ThDeDeyn/ELEC_424_Project/README.md

# ELEC_424_Project
This repository includes all the codes used for the project "Smart Care Wound : Device Design", part of the course ELEC-424 (Active Medical Device)

All the codes used in the project are uploaded to this repository. 
Additional documents used are also provided in this repository. 

The members of the group are : 

- Thomas De Deyn (ULB)
- Kiên Tran Ngoc (ULB)
- Mohamed Elamri (ECAM)
- Hugo De Marez (ULB)
