ThDeDeyn/ELEC_424_Project/_Report/ELEC-H424_SmartWoundCare_DeviceDesign.pdf

# Smart Wound Care: Device design

### Active Medical Device (ELEC-H424)

## 1. Introduction

## 2. Biomarkers

## 3. Sensors

## 4. PCB

## 5. Prototype

### - Chronic wounds :

- Result from variety of medical conditions (obesity, hypertension, …)

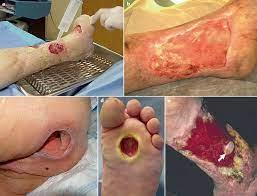
[picture p1: figure]

### - Crucial to monitor the progression of a wound - Nowadays = visual inspection of the skin - Goal = use smart bandages

## 1. Introduction

## 2. Biomarkers

## 3. Sensors

## 4. PCB

## 5. Prototype

pH

### - Infection indicator marker

### - Normal skin : pH alkaline (≈7)

### - Wound : pH between 5.5 and 6.5

### - pH>6 ➔ appearance of human-pathogenic bacteria

### - Incidence on the effectiveness of antibiotics and antiseptics

# - Biochemical markers

Disadvantage(s)

- Very expensive sensor
- Length of the sensor (10 cm minimum)

Advantage(s)

- Precise information

# - Physical markers

### Temperature

### - Infection indicator marker

### - Increasing temperature around a wound associated to the presence of an infection

Disadvantage(s)

- Depends on the environment’s temperature
- Could vary a lot during the day (exercise,…)

Advantage(s)

- Very easy to measure
- Associated to a defence
mechanism
- Cheap sensor

### Oxygen

### - Slow recovery monitoring marker

### - Concentration around a wound = important factor for healing

### - Helps eliminate bacteria and debris in the wound

Disadvantage(s)

- sp02 sensor
- More expensive than other sensors

Advantage(s)

- Constant value
- Small sensor

### Humidity

### - Slow recovery monitoring marker

### - Wound moisture balance = critical for optimum healing conditions

Disadvantage(s)

- Sensor must be placed closed to the wound

Advantage(s)

- Easy to measure
- Small & cheap sensor

### Pressure

### - Slow recovery monitoring marker

### - Exerted pressure ranges from 14 to 40 mmHg in the bandages

Disadvantage(s)

- Sensor must be placed closed to the wound

Advantage(s)

- Easy to measure
- Improves the healing speed
- Cheap sensor

## 1. Introduction

## 2. Biomarkers

## 3. Sensors

## 4. PCB

## 5. Prototype

# Sensors

### Control board – Arduino Nano 33 BLE

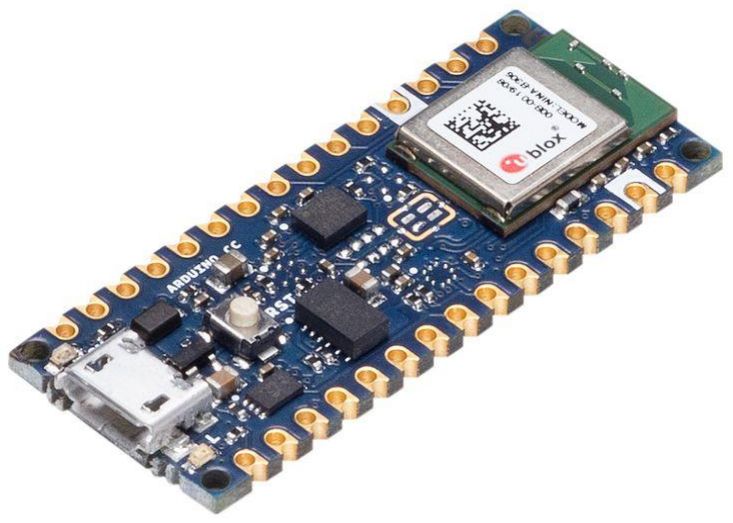
[picture p2: figure]

- Voltage output : 5V and 3.3V
- Communication protocol: I2C capable,

Bluetooth serial communication

- Coding language : C++ based
- Accessibility : fast delivery, relatively

cheap

- Improved performanceq: enables to treat

all the data needed

# Sensors

### Humidity and temperature sensor – SHT40-AD1B-R2

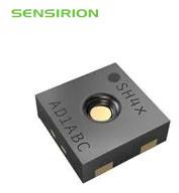
[picture p3: figure]

- Accuracy on the humidity : ± 1%
- Accuracy on the temperature : ± 0.1°C (@25°C)
- Power supply : 1.08V to 3.6V, Ultra-low-power
- Accessibility : available by 1
- Ease of use : Library available and I2C capable

# Sensors

### Oxygen level sensor – MAXREFDES117

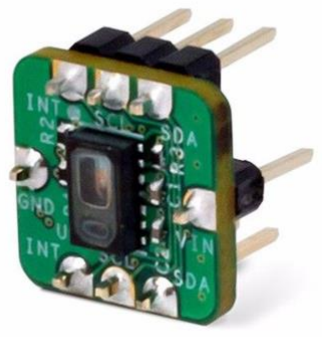
[picture p4: figure]

- Accuracy : ± 2% (for saturation levels ranging from

70% to 100%

- Power supply : 2V to 5.5V
- Accessibility : available by 1
- Ease of use : Open source library available and I2C

capable

# Sensors

### Pressure sensor – Round Force Sensor FSR402

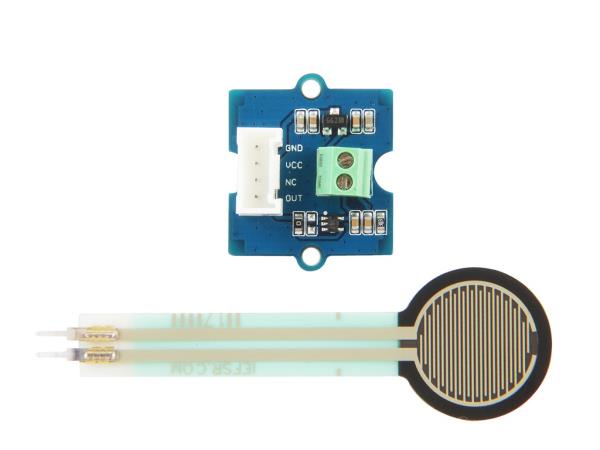
[picture p5: figure]

- Accuracy : Continuous (analog)
- Power supply : 3.3V or 5V
- Accessibility : available by 1
- Ease of use : Value directly read using the µC

(Analog input pin)

## 1. Introduction

## 2. Biomarkers

## 3. Sensors

## 4. PCB

## 5. Prototype

# PCB

## Why was it important ?

### - Good connection between the components

### - Simplify wiring and reduced short-circuit risks

### - Space optimisation

### - Improved comfort and discretion for patients

# PCB

### Issues :

### - Pin → 0,3mm ∅

### - Road as wide as possible (1mm)

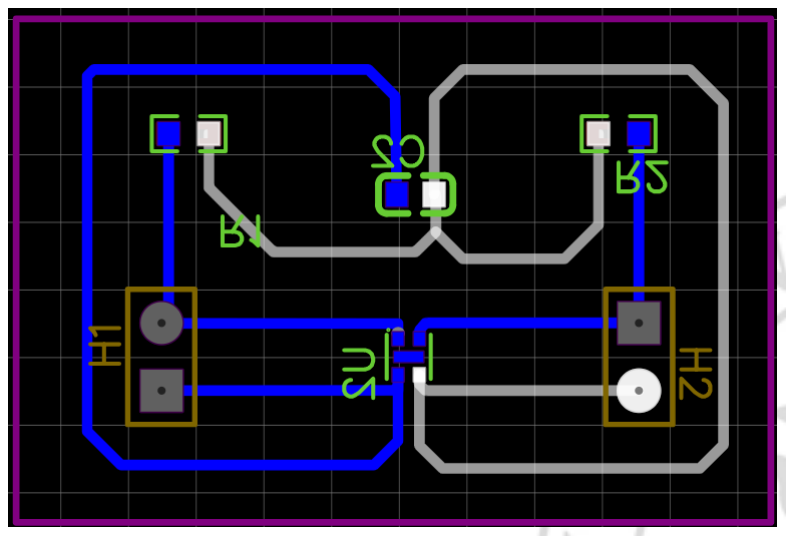
[picture p6: figure]

### - Create a PCB for the humidity sensor

# PCB

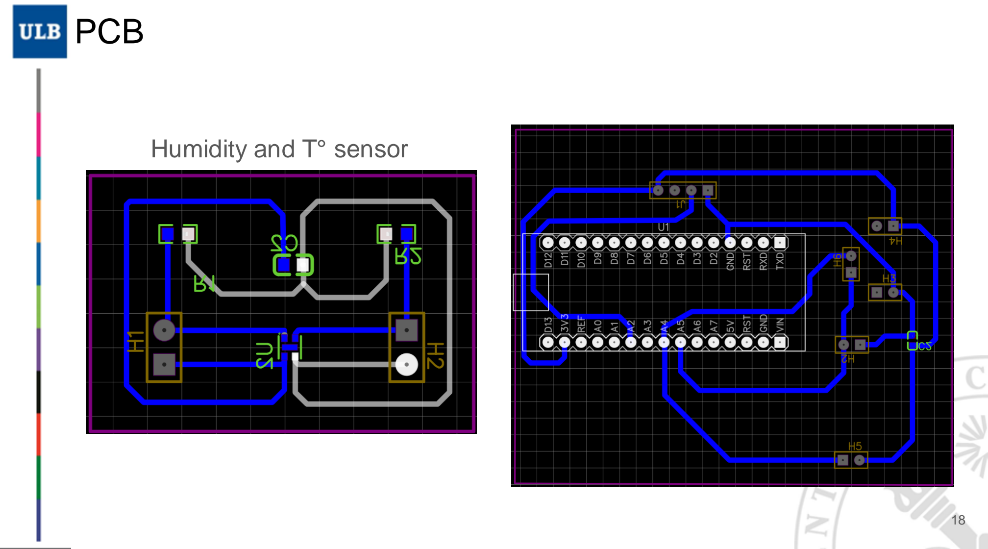
[picture p7: page 18]

### Humidity and T° sensor

## 1. Introduction

## 2. Biomarkers

## 3. Sensors

## 4. PCB

## 5. Prototype

# Prototype

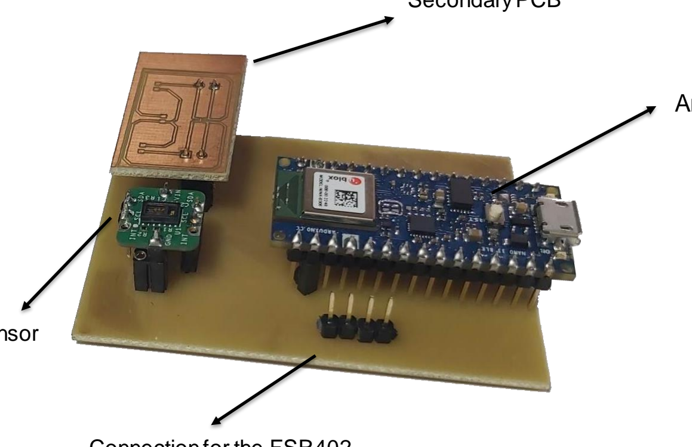
[picture p8: figure]

Arduino Nano

spO2 sensor

Secondary PCB

Connection for the FSR402

# Prototype : current state

### - Validation step proposed:

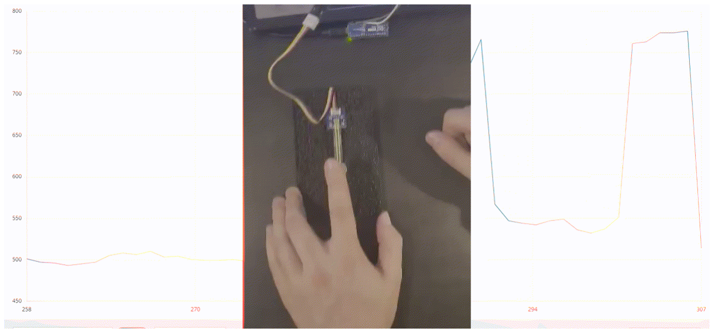
[picture p9: figure]

- Using balance weights placed on the sensor

## - Measuring the pressure

# Prototype : current state

## - Measuring the temperature

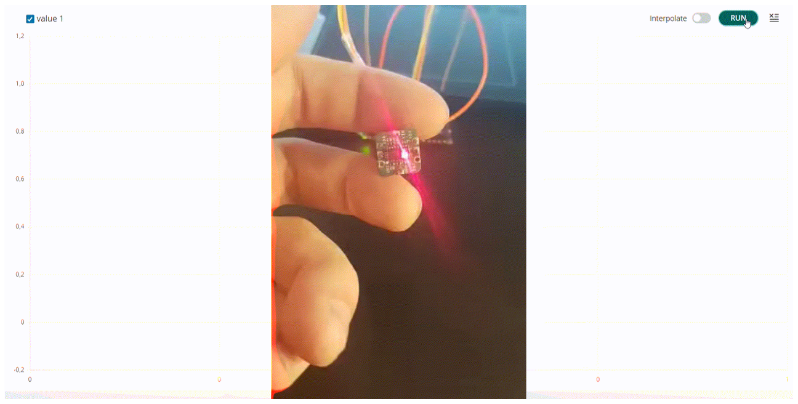
[picture p10: figure]

### - Validation steps performed :

- Placing a finger on the sensor raises the temperature
- Placing a cooled finger on the sensor decreases the temperature

# Prototype : current state

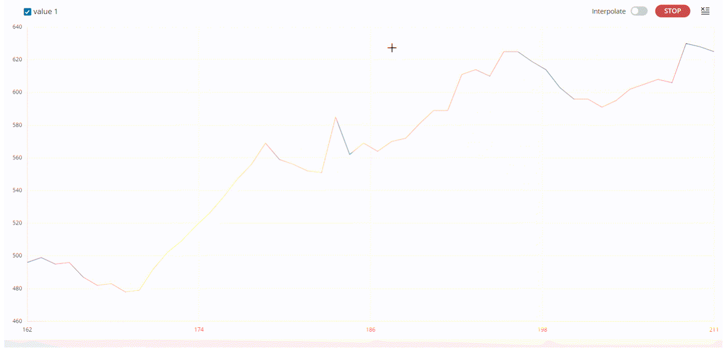
[picture p11: figure]

### - Validation steps performed :

- Compared with an hospital-grade oxymeter
- BPM value measured by hand

## - Measuring the BPM and spO2

# Prototype : current state

## - Measuring the BPM and spO2

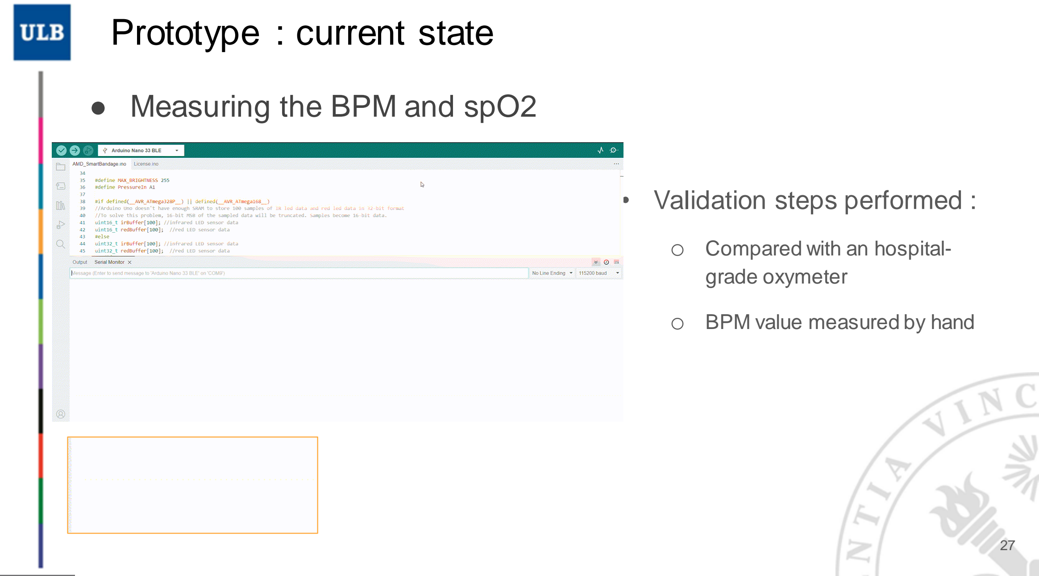
[picture p12: page 24]

### - Validation steps performed :

- Compared with an hospital-grade oxymeter
- BPM value measured by hand

# Prototype : next steps

## What remains to be done to test it in real conditions?

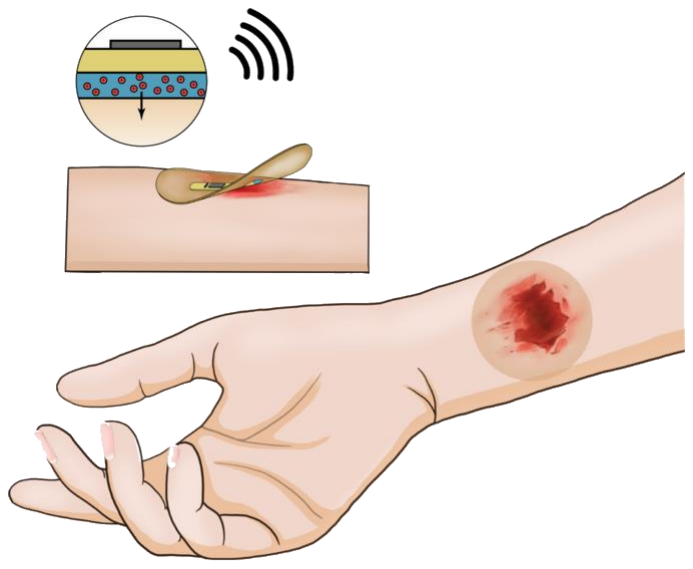
[picture p13: figure]

Jian-Cheng Lai, Bao Research Group (Stanford University)

# Prototype : next steps

### - Using the SHT40

### - Test both PCBs

### - Choosing a more adequate shape for the pressure sensor

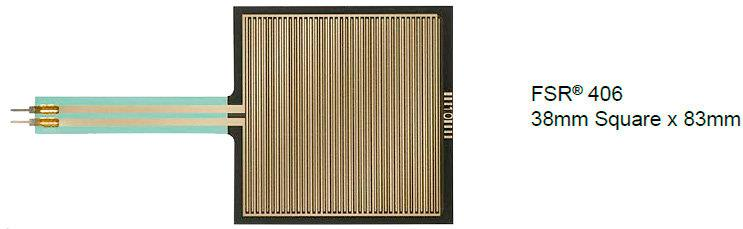
[picture p14: figure]

# Prototype : next steps

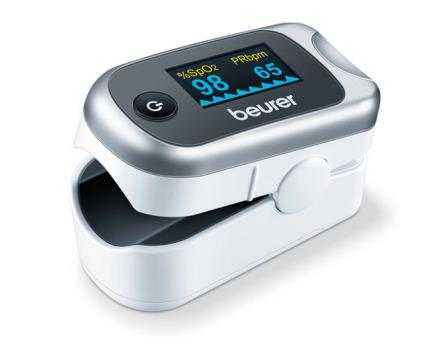
[picture p15: figure]

### - Stabilise the sensors

### - Develop a wearable circuit

- Using a flexible PCB
- Reducing the size of the components
- Apply safety standards
- Allow wireless communication

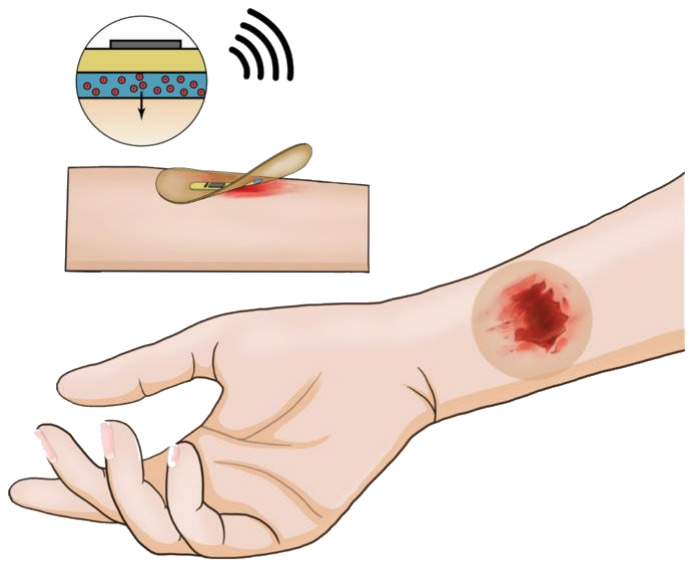
[picture p16: figure]

Jian-Cheng Lai, Bao Research Group (Stanford University)

# Thank you for your attention!

# Any questions?

### Active Medical Device (ELEC-H424)

# Other non-selected Markers

### - Nitric oxide

- Promotes cell growth, cell migration, new blood vessel formation and stimulation of collagen production
- Concentration between50 and 500 nM
- No sensor for aqueous environment

### - Uric acid

- Waste product
- Indicator of oxidative stress and bacterial infection
- Chronic wounds = hypoxic ➔ increase of purine metabolites concentration
- Too large

### - Proteases

- responsible for the balance between extracellular matrix (ECM) degradation and deposition
- Disrupt in the balance ➔ state of chronic inflammation
- Too complex (colorimetric or fluorescent study ➔ need of light and camera)

# Markers

### - Summary of the different markers proposed

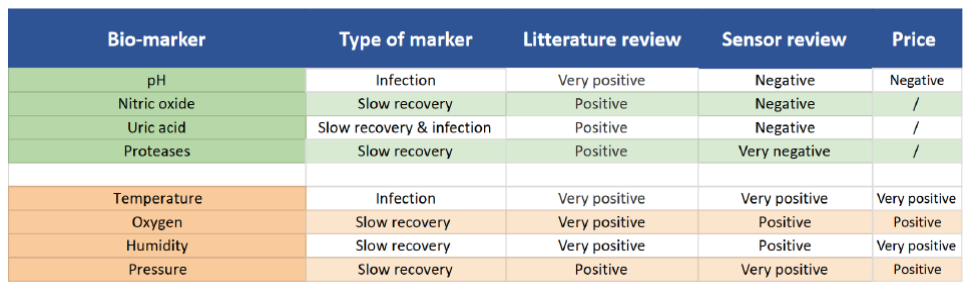
[picture p17: figure]

Depending on the review, the characteristic’s review will either be "Very positive " ( The review encourages the use of this marker ), "Positive", "Neutral", "Negative" ( The review raises important issues ) and "Very negative" ( One point in the review prevents the use of this sensor ).

# PCB

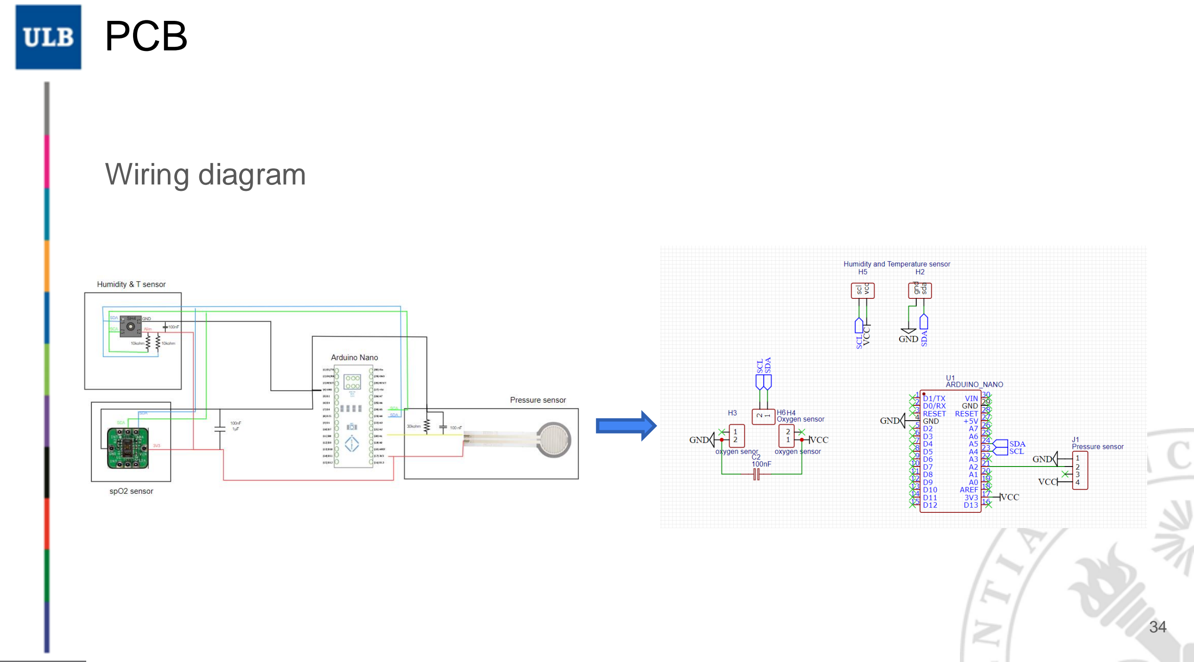
[picture p18: page 31]

### Wiring diagram

# Arduino Libraries

- The SparkFun library used for most of the measures taken.

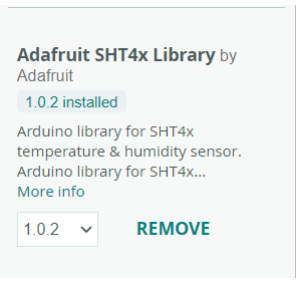
[picture p19: figure]
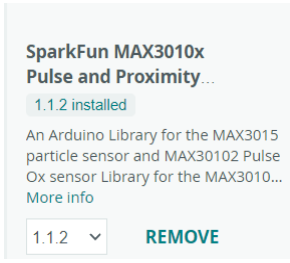
[picture p20: figure]
