ThDeDeyn/ELEC_424_Project/_Additional Documentation/2. SensorsSelec/ELEC-H424-sensors.xlsx

Sheet: ShoppingList
Product | WebLink | Reference | Price | Estimated Delivery Delay | Qt | Additional information | 5V or 3,3V ? | In circuit
Controller | https://store.arduino.cc/products/arduino-nano-33-ble | Arduino Nano 33 BLE | 22.80 € | max 7 days | 1 |  | / | TRUE
Controller's connection | https://store.arduino.cc/products/nano-screw-terminal?variant=42702175338647 | Nano Screw Terminal Adapter | 10.90 € | max 7 days | 1 |  | /
Controller's connection | https://www.amazon.fr/ANGEEK-Single-Breakable-Connector-Arduino/dp/B07XXXNH9V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 | Pin Header | 8.99 € | 2 days | 1 | Disponible au BEAMS ? | /
Controller's connection | https://store.arduino.cc/products/usb-cable-type-a-male-to-micro-type-b-male | USB Cable | 5.90 € | max 7 days | 1 |  | /
Humidity & Temperature | https://www.mouser.be/ProductDetail/Sensirion/SHT40-AD1B-R2 | SHT40-AD1B-R2 | 2.54 € | 4 days | 1 | https://learn.adafruit.com/adafruit-sht40-temperature-humidity-sensor/arduino |  | TRUE
Pressure | https://www.mouser.be/ProductDetail/Seeed-Studio/101020553?qs=MLItCLRbWsyXlNYY3BA9uA%3D%3D | 101020553 | 13.53 € | 4 days | 1 | Autres modèles (tailles) dispos mais pas trouvés | TRUE | FALSE
Oxygen | https://www.mouser.be/ProductDetail/Maxim-Integrated/MAXREFDES117?qs=L5CenAjuTY7RgAB22JU8Sw%3D%3D | MAXREFDES117# | 25.94 € | 4 days | 1 | voir site pour plus d'infos | TRUE | FALSE
pH | https://www.sigmaaldrich.com/BE/en/product/aldrich/z264946 | Z264946-1EA | 158.00 € | 1 week | 1 |  | /
 | https://eu.mouser.com/ProductDetail/Texas-Instruments/LMP7721MA-NOPB?qs=7lkVKPoqpbayTMxXZQmMRA%3D%3D | LMP7721MA/NOPB | 12.66 € | 4 days | 2 | 6,33 per unit | TRUE
 | https://www.mouser.be/ProductDetail/Texas-Instruments/LM4140ACM-1.0-NOPB?qs=QbsRYf82W3Hc9FiwUZTQHw%3D%3D | LM4140ACM-1.0/NOPB | 6.14 € | 4 days |  | for more accurate measurements | TRUE
pH' | https://www.zimmerpeacocktech.com/products/electrochemical-sensors/ph-sensor/ |  |  |  |  |  | /
Total : | 267.40 € |  | 267.40 €
Sans le pH : | 90.60 €

Sheet: T
Type of sensors | WebLink | Reference | Price | Accessibility | Size [mm] | Range [°C] | Precision [°C] | Resistance value @25°C | Consumption [µA] | Dissipation constant [mW/°C] | Maximum Power [mW] | VDD [V] | A/D resolution [°C]
 |  |  |  |  |  |  |  |  |  |  |  |  | /
Thermistors | https://befr.rs-online.com/web/p/thermistors/2618119 | GA100K6MCD1 | 15.00 € | by 100 | ⌀2,4 | -40/125 | ~0,2°C @25°C |  | / |  |  |  | /
 | https://befr.rs-online.com/web/p/thermistors/2618121 | GA100K6MCD1 | 28.05 € | by 1 | ⌀2,4 | -40/125 | ~0,2°C @25°C | 100 kOhms | / |  |  |  | /
NTC | https://www.mouser.be/ProductDetail/Amphenol-Advanced-Sensors/SC30F103VN | SC30F103VN | 7.39 € | by 1 | ⌀1,5 | -40/105 | 0,1°C @25°C | 10 kOhms | / |  | 50 |  | /
NTC | https://www.mouser.be/ProductDetail/Measurement-Specialties/GA5K3A1A | GA5K3A1A | 13.40 € | by 1 | ⌀2,4 | -40/125 | 0,1°C @25°C | 5 kOhms |  | 0.75 |  |  | /
NTC | https://www.mouser.be/ProductDetail/Amphenol-Advanced-Sensors/SC50F103VN | SC50F103VN | 8.06 € | by 1 | ⌀1,5 | -40/105 | 0,1°C @25°C | 10 kOhms |  |  | 50 |  | /
 |  |  |  |  |  |  |  |  |  |  |  |  | /
NTC | https://www.mouser.be/ProductDetail/Measurement-Specialties/PTFC102T1G0 | PTFC102T1G0 | 6.00 € | by 1 | 2x4x0,4 | -30/200 | 0,1°C @25°C | 1 kOhms | 400 |  |  |  | /
 |  |  |  |  |  |  |  |  |  |  |  |  | /
I2C sensor | https://www.analog.com/en/products/max30208.html#product-designs | MAX30208 | 5.06 € | by 2500 (by 1 on Mouser) | 2x2x0,75 | 30/50 | 0,1°C @25°C |  | 0,5 (idle) & 67 µA |  |  | 1,7 to 3,6 | 0,005 (16 bits)
 |  |  |  | Long delivery time

Sheet: P
Type of sensors | WebLink | Reference | Price | Accessibility | Size | mass (g) | Mechanism | Driving in [mm] | Pressure range [mmHg] | Accuracy [%] | Sentivity [%] | Minimum operating temperature (°C) | Maximum operating temperature (°C) | Operatin supply current [uA] | Operating supply voltage [V] | Minimum Supply voltage (V) | Maximum supply voltage (V)
Biometric pressure sensor (100 mmHg) | https://www.mouser.be/ProductDetail/Amphenol-Advanced-Sensors/NPC-100T?qs=fSIr1QPo%2F%2FQfxzj%252BgNQZTw%3D%3D | 527-NPC-100T | 9.93€ | by 1 | See schema | 2 | Press | 8 | -50 to 300 |  | +-1 | 15 | 40 |  | 10 | 1 | 10
Biometric pressure sensor (100 mmHg) | https://www.mouser.be/ProductDetail/Amphenol-Advanced-Sensors/NPC-120T?qs=fSIr1QPo%2F%2FT60LhI3STpaw%3D%3D | 527-NPC-120T | 10.14 € | by 1 | See schema | 2 | Press | 6 | -30 to 300 |  | +-1 | 15 | 40 |  | 6 | 1 | 10
Biometric pressure sensor (100 mmHg) | https://www.mouser.be/ProductDetail/Amphenol-Advanced-Sensors/NPC-100?qs=fSIr1QPo%2F%2FSdIqkwETzEIQ%3D%3D | 527-NPC-100 |  | not available | See schema |  | Press | 8 | -50 to 300 |  | +-1 | 15 | 40 |  | 10 | 1 | 10
Biometric pressure sensor (100 mmHg) | https://www.mouser.be/ProductDetail/Amphenol-Advanced-Sensors/NPC-120?qs=fSIr1QPo%2F%2FS9k1W5DsD8NQ%3D%3D | 527-NPC-120 |  | not available | See schema |  |  | 6 |  |  | +-1
Blood-pressure sensor | https://www.mouser.be/ProductDetail/Merit-Sensor/BP0001?qs=OgJBIms1vdXYVyLuNkPUaQ%3D%3D | 753-901051004 | 9.32 € | by 1 | See schema | 1.507 |  |  | -30 to 300 | 3 | +-1 | 15 | 40 | 2 | 6 | 1 | 10
Pressure sensor | https://befr.rs-online.com/web/p/pressure-sensor-ics/2362712?matchtype=&pla-299746055678&gclsrc=aw.ds | MPRLS0001PG0000SC | 16.06 € | by 1 |  |  |  |  | 0 to 2500 mbar | +- 0.25 |  | -40 | 85 |  | 3.3 | -0.3 | 3.6
 | https://www.mouser.be/ProductDetail/Seeed-Studio/101020553?qs=MLItCLRbWsyXlNYY3BA9uA%3D%3D

Sheet: Humid.
Type of sensors | WebLink | Reference | Price | Accessibility | Size [mm] | Range [%RH] | Precision [%RH] | Range [°C] | Precision [°C] | V supply [V] | Consumption [µA] | A/D resolution [%RH]
Humid & T I2C | https://www.mouser.be/ProductDetail/Sensirion/SHT45-AD1B-R3 | SHT45-AD1B-R3 | 7.58 € | by 1, | 1,5x1,5,05 | 0-100 | +-1 | 5/60 | +-0,1°C | 3.3 | 0,08 (idle) & 320 (measure) | 0.01
Humid & T I2C | https://www.mouser.be/ProductDetail/Sensirion/SHT33-DIS-B2.5kS | SHT33-DIS-B2.5kS | 9.02 € | by 1, | 2,5x2,5x0,8 | 0-100 | +-2 | -40/125 | +-0,48°C | 3.3 | 0,2 (idle) | 0.01
Humid & T I2C | https://www.mouser.be/ProductDetail/Sensirion/SHT40-AD1F-R2 | SHT40-AD1F-R2 | 2.92 € | by 1, | 1,5x1,5x0,5 | 0-100 | +- 1,8 | -40/125 | +-0,2°C | 3.3 | ? | ?
Humid & T I2C | https://www.mouser.be/ProductDetail/Sensirion/SHT40-AD1B-R2 | SHT40-AD1B-R2 | 2.54 € | by 1, | 1,5x1,5x0,5 | 0-100 | +- 1,8 | -40/125 | +- 0,1°C | 3.3 | 0,080 (idle) & 0,350 (meas.) | 0.01
Humid | https://www.mouser.be/ProductDetail/Honeywell/HIH-5030-001 | HIH-5030-001 | 21.38 € | by 1 | 8,6x4,2x2,7 | 0-100 | +-3 | / | / | 3 | 200 | /
Humid & T | https://www.mouser.be/ProductDetail/Texas-Instruments/HDC2021DEBT?qs=sPbYRqrBIVm3WSOvOR710w%3D%3D | HDC2021DEBT | 5.31 € | by 1 | ⌀330 | 0-100 | +-2 | -40/125 | +-0,2°C | 1.4 | 0,05 (idle) & 0,55 (meas)
Humid & T | https://www.mouser.be/ProductDetail/Texas-Instruments/HDC2022DEPT?qs=sPbYRqrBIVmE3TRY2BVyFw%3D%3D | HDC2022DEPT | 5.31 € | by 2 | 3x3x1,15 | 0-100 | -2 | -40/126 | +-0,2°C |  | 0,05 (idle) & 0,55 (meas) |  | IP67
Preferred: | https://www.mouser.be/ProductDetail/Sensirion/SHT40-AD1B-R2 | SHT40-AD1B-R2 | 2.54 € | by 1, | 1,5x1,5x0,5 | 0-100 | +- 1,8 | -40/125 | +- 0,1°C | 3.3 | 0,080 (idle) & 0,350 (meas.) | 0.01

Sheet: Oxygen
Type of sensors | WebLink | Reference | Price | Accessibility | Size [mm] | Range [SPO2] | Consumption [mA]
Oxygen level | https://www.fruugo.be/gy-max30100-module-de-capteur-de-concentration-d%E2%80%99oxygene-de-frequence-cardiaque-haute-sensibilite/p-149075517-314785771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 | GY-MAX30100 | 11.20 € | by 1 | 14,0 x 20,0 x 3,3 | 0 - 100% | 1.8
Oxygen level | https://www.123materialen.com/products/max30102-hartslagsensormodule-ultra-laag-stroomverbruik_1380585 | MAX30102 | 28.99 € | by 1 | 12,7 x 12,7 | 0-100% | 1.8
Oxygen level | https://fr.discountoffice.be/p/whadda-max30102-heart-rate-and-oxygen-sensor/ | MAX30102 | 15.20 € | by 1 | 20,0 X 35,2 X 7,2 | 0-100% | 1.6

Sheet: Uric acid
Type of sensors | WebLink | Reference | Price | Sample size | Size | Operating temperature
Blood uric acid sensor | https://www.uasure.com/uasure-meter-specifications/ |  | 79,99$ | 1.5 µL | 3.2 x 1.9 x 0.5 in | 10-37°C

Sheet: pH
Type of sensors | WebLink | Reference | Price [per unit] | Accessibility | Size | mass (g) | Mechanism | Driving in [mm] | Pressure range [mmHg] | Accuracy [%] | Sentivity [%] | Minimum operating temperature (°C) | Maximum operating temperature (°C) | Operatin supply current [uA] | Operating supply voltage [V] | Minimum Supply voltage (V) | Maximum supply voltage (V)
pH sensor | https://m-oem.com/pages/ph-sensors
pH sensor on eval platform | https://www.ti.com/tool/LMP91200EVAL | https://www.ti.com/lit/ug/snau122a/snau122a.pdf?ts=1679965395195
pH sensor electrode | https://www.ti.com/lit/ml/snoa529a/snoa529a.pdf?ts=1679941063057
Wearable pH sensor | https://www.zimmerpeacocktech.com/products/electrochemical-sensors/ph-sensor/ | ZPS CIO-000-00064 | 39.50 € | by 10, 3-4 weeks | 24,4x7x0,6
Wearable pH sensor | https://www.zimmerpeacocktech.com/products/electrochemical-sensors/ph-sensor/ | ZPS Hypervalue | 38.50 € | by 10, 3-4 weeks
Wearable pH sensor | https://www.zimmerpeacocktech.com/products/electrochemical-sensors/ph-sensor/ | ZP pH mini-electrode array | 100.00 € | by 5, 3-4 weeks

Sheet: Nitric Oxide
Type of sensors | WebLink | Reference | Price | Accessibility | Size [mm] | Consumption [mA]
Nitic Oxide (gas) | https://www.amazon.com.be/-/nl/AZDelivery-MQ-135-luchtkwaliteitsmodule-compatibel-Arduino/dp/B07CNR9K8P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 | MQ-135 | 5.99 € | By 1 | 30x20 | 1.8
Nitic Oxide (gas) | https://www.dennisdeal.com/products/ze25-o3-ozone-o3-gas-sensor-module-gas-sensor-for-ozone-monitor-0-10ppm-with-uart-analog-voltage-pwm-wave-ze25-o3_1611521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 | ze25-o3 | 61.69 € | by 1 | / | 1.8

Sheet: Protease
Type of sensors | WebLink | Reference | Price | Accessibility | Size | mass (g) | Mechanism | Driving in [mm] | Pressure range [mmHg] | Accuracy [%] | Sentivity [%] | Minimum operating temperature (°C) | Maximum operating temperature (°C) | Operatin supply current [uA] | Operating supply voltage [V] | Minimum Supply voltage (V) | Maximum supply voltage (V)
 |  |  |  |  |  |  |  |  |  |  | +-1 | 15 | 40 |  | 10 | 1 | 10
Colorimetric | Pierce™ Colorimetric Protease Assay Kit (thermofisher.com) (https://www.thermofisher.com/order/catalog/product/23263) |  | 404.00 € | Non availlable |  |  |  |  |  |  | +-1 | 15 | 40 |  | 6 | 1 | 10
Colorimetric | Protease Assay Kit | 539125 (merckmillipore.com) (https://www.merckmillipore.com/BE/fr/product/Protease-Assay-Kit,EMD_BIO-539125) |  | 507.00 € |  |  |  |  |  |  |  | +-1 | 15 | 40 |  | 10 | 1 | 10
 |  |  |  |  |  |  |  |  |  |  | +-1
 |  |  |  |  |  |  |  |  |  | 3 | +-1 | 15 | 40 | 2 | 6 | 1 | 10
 |  |  |  |  |  |  |  |  |  | +- 0.25 |  | -40 | 85 |  | 3.3 | -0.3 | 3.6
