ThDeDeyn/ELEC_424_Project/_Additional Documentation/3. Electric&PCB/ELEC-H424 Wiring.pdf

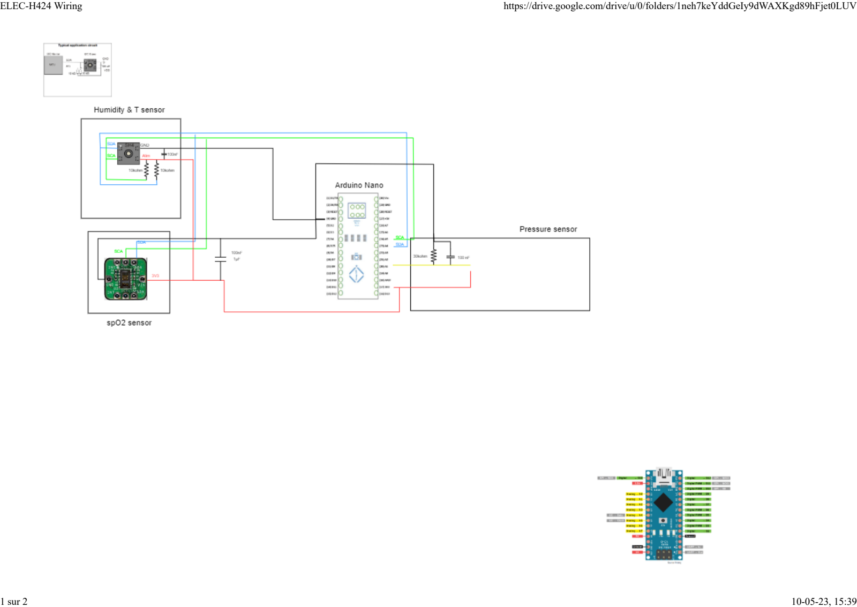
[picture p31: page 1]

ELEC-H424 Wiring | https://drive.google.com/drive/u/0/folders/1neh7keYddGeIy9dWAXKgd89hFjet0LUV
1 sur 2 | 10-05-23, 15:39
