ThDeDeyn/ELEC_424_Project/AMD_SmartBandageV2/AMD_SmartBandageV2.ino

/* 
  This code has been used as a base for the project "Smart Wound Care : Device Design" included in the course "ELEC-H424 : Active Medical Device"

  This code is based on the example provided by te SparkFun library by Nathan Seidle (https://github.com/sparkfun/MAX30105_Breakout)
  The modifications made allow it to  measure the force applied on the FSR402 sensors and the temperature through the MAXREF. 


  Hardware Connections for the O2 Sensor (to Arduino Nano 33 BLE):
  -VIN= 3.3V
  -GND = GND
  -SDA = A4 (= SDA)
  -SCL = A5 (= SCL)
  -INT = Not connected

  It is recommended to attach the sensor to the finger for accurate measurement. The sensor is sensible to small movement and/or small modification in the pressure
  applied on it. 

  Hardware Connections for the pressure sensor (to Arduino Nano 33 BLE)
  -VCC = 3.3V
  -GND = GND
  -NC = Not connected 
  -OUT = A1

By: Thomas De Deyn @ Ecole Polytechnique de Bruxelles (MA1 M-IRCBS)
Date : May 4th, 2023
*/

#include <Wire.h>
#include "MAX30105.h"
#include "spo2_algorithm.h"

MAX30105 particleSensor;

#define MAX_BRIGHTNESS 255
#define PressureIn A1

#if defined(__AVR_ATmega328P__) || defined(__AVR_ATmega168__)
//Arduino Uno doesn't have enough SRAM to store 100 samples of IR led data and red led data in 32-bit format
//To solve this problem, 16-bit MSB of the sampled data will be truncated. Samples become 16-bit data.
uint16_t irBuffer[100]; //infrared LED sensor data
uint16_t redBuffer[100];  //red LED sensor data
#else
uint32_t irBuffer[100]; //infrared LED sensor data
uint32_t redBuffer[100];  //red LED sensor data
#endif
uint32_t prBuffer[100];
uint16_t TBuffer[100];

int32_t bufferLength; //data length
int32_t spo2; //SPO2 value
int8_t validSPO2; //indicator to show if the SPO2 calculation is valid
int32_t heartRate; //heart rate value
int8_t validHeartRate; //indicator to show if the heart rate calculation is valid

byte pulseLED = 11; //Must be on PWM pin
byte readLED = 13; //Blinks with each data read

void setup()
{
  Serial.begin(115200); // initialize serial communication at 115200 bits per second:

  pinMode(pulseLED, OUTPUT);
  pinMode(readLED, OUTPUT);

  // Initialize sensor
  if (!particleSensor.begin(Wire, I2C_SPEED_FAST)) //Use default I2C port, 400kHz speed
  {
    Serial.println(F("MAX30105 was not found. Please check wiring/power."));
    while (1);
  }

  Serial.println(F("Attach sensor to finger with rubber band. Press any key to start conversion"));
  while (Serial.available() == 0) ; //wait until user presses a key
  Serial.read();

  byte ledBrightness = 60; //Options: 0=Off to 255=50mA
  byte sampleAverage = 4; //Options: 1, 2, 4, 8, 16, 32
  byte ledMode = 2; //Options: 1 = Red only, 2 = Red + IR, 3 = Red + IR + Green
  byte sampleRate = 100; //Options: 50, 100, 200, 400, 800, 1000, 1600, 3200
  int pulseWidth = 411; //Options: 69, 118, 215, 411
  int adcRange = 4096; //Options: 2048, 4096, 8192, 16384

  particleSensor.setup(ledBrightness, sampleAverage, ledMode, sampleRate, pulseWidth, adcRange); //Configure sensor with these settings
  particleSensor.enableDIETEMPRDY();
}

void loop()
{
  bufferLength = 100; //buffer length of 100 stores 4 seconds of samples running at 25sps

  //read the first 100 samples, and determine the signal range
  for (byte i = 0 ; i < bufferLength ; i++)
  {
    while (particleSensor.available() == false) //do we have new data?
      particleSensor.check(); //Check the sensor for new data

    redBuffer[i] = particleSensor.getRed();
    irBuffer[i] = particleSensor.getIR();
    prBuffer[i] = analogRead(PressureIn); //Reading the pressure value
    TBuffer[i] = particleSensor.readTemperature(); //Reading the temperature

    particleSensor.nextSample(); //We're finished with this sample so move to next sample

    Serial.print(F("red="));
    Serial.print(redBuffer[i], DEC);
    Serial.print(F(", ir="));
    Serial.print(irBuffer[i], DEC);
    Serial.print(F(", pr="));
    Serial.print(prBuffer[i], DEC);
    Serial.print(F(", T="));
    Serial.println(TBuffer[i], DEC);
    // Anytime the red or ir is measured,the pressure on the sensor will also be measured
  }

  //calculate heart rate and SpO2 after first 100 samples (first 4 seconds of samples)
  maxim_heart_rate_and_oxygen_saturation(irBuffer, bufferLength, redBuffer, &spo2, &validSPO2, &heartRate, &validHeartRate);

  //Continuously taking samples from MAX30102.  Heart rate and SpO2 are calculated every 1 second
  while (1)
  {
    //dumping the first 25 sets of samples in the memory and shift the last 75 sets of samples to the top
    for (byte i = 25; i < 100; i++)
    {
      redBuffer[i - 25] = redBuffer[i];
      irBuffer[i - 25] = irBuffer[i];
      prBuffer[i - 25] = prBuffer[i];
      TBuffer[i - 25] = TBuffer[i];
    }

    //take 25 sets of samples before calculating the heart rate.
    for (byte i = 75; i < 100; i++)
    {
      while (particleSensor.available() == false) //do we have new data?
        particleSensor.check(); //Check the sensor for new data

      digitalWrite(readLED, !digitalRead(readLED)); //Blink onboard LED with every data read

      redBuffer[i] = particleSensor.getRed();
      irBuffer[i] = particleSensor.getIR();
      prBuffer[i] = (20/1000)*analogRead(PressureIn); //Reading the pressure value
      TBuffer[i] = particleSensor.readTemperature(); //Reading the temperature

      particleSensor.nextSample(); //We're finished with this sample so move to next sample

      //send samples and calculation result to terminal program through UART
      Serial.print(F("T="));
      Serial.print(TBuffer[i], DEC);
      Serial.print(F(", pr="));
      Serial.print(prBuffer[i], DEC);
    

      Serial.print(F("N, SPO2="));
      Serial.print(spo2, DEC);

      Serial.print(F(", SPO2Valid=")); //Determine wether the value computed is valid or not. Might indicate the finger is not properly positionned 
      Serial.println(validSPO2, DEC);
    }

    //After gathering 25 new samples recalculate HR and SP02
    maxim_heart_rate_and_oxygen_saturation(irBuffer, bufferLength, redBuffer, &spo2, &validSPO2, &heartRate, &validHeartRate);
  }
}
