ThDeDeyn/ELEC_424_Project/(commit log)

2023-05-09 Code pressure added
2023-05-10 Bio-markers added
    [ELEC-H424-sensors.xlsx]
2023-05-10 Wiring pdf added
    [ELEC-H424-sensors.xlsx]
2023-05-12 PCB files added
2023-05-13 Adding requested changes
    [ELEC-H424-sensors.xlsx]
2023-05-23 Final Videos
    These are the videos included in the Powerpoint presented on the 24-05-23 (final presentation of the AMD project)
2023-05-23 PPT added
    Powerpoints in .pdf
